IowaScaledEngineering/ckt-iiab/pg/ckt-iiab-test-v1.0-c82176f/ckt-iiab-test-drc.txt

** Drc report for /home/ndholmes/data/projects/ckt-iiab/kicad/ckt-iiab-test/ckt-iiab-test.kicad_pcb **
** Created on 2024-12-31 19:53:41 **

** Found 0 DRC violations **

** Found 0 unconnected pads **

** Found 0 Footprint errors **

** End of Report **
