IowaScaledEngineering/ckt-iiab/pg/ckt-iiab-test-v1.0-c82176f/ckt-iiab-test.pdf

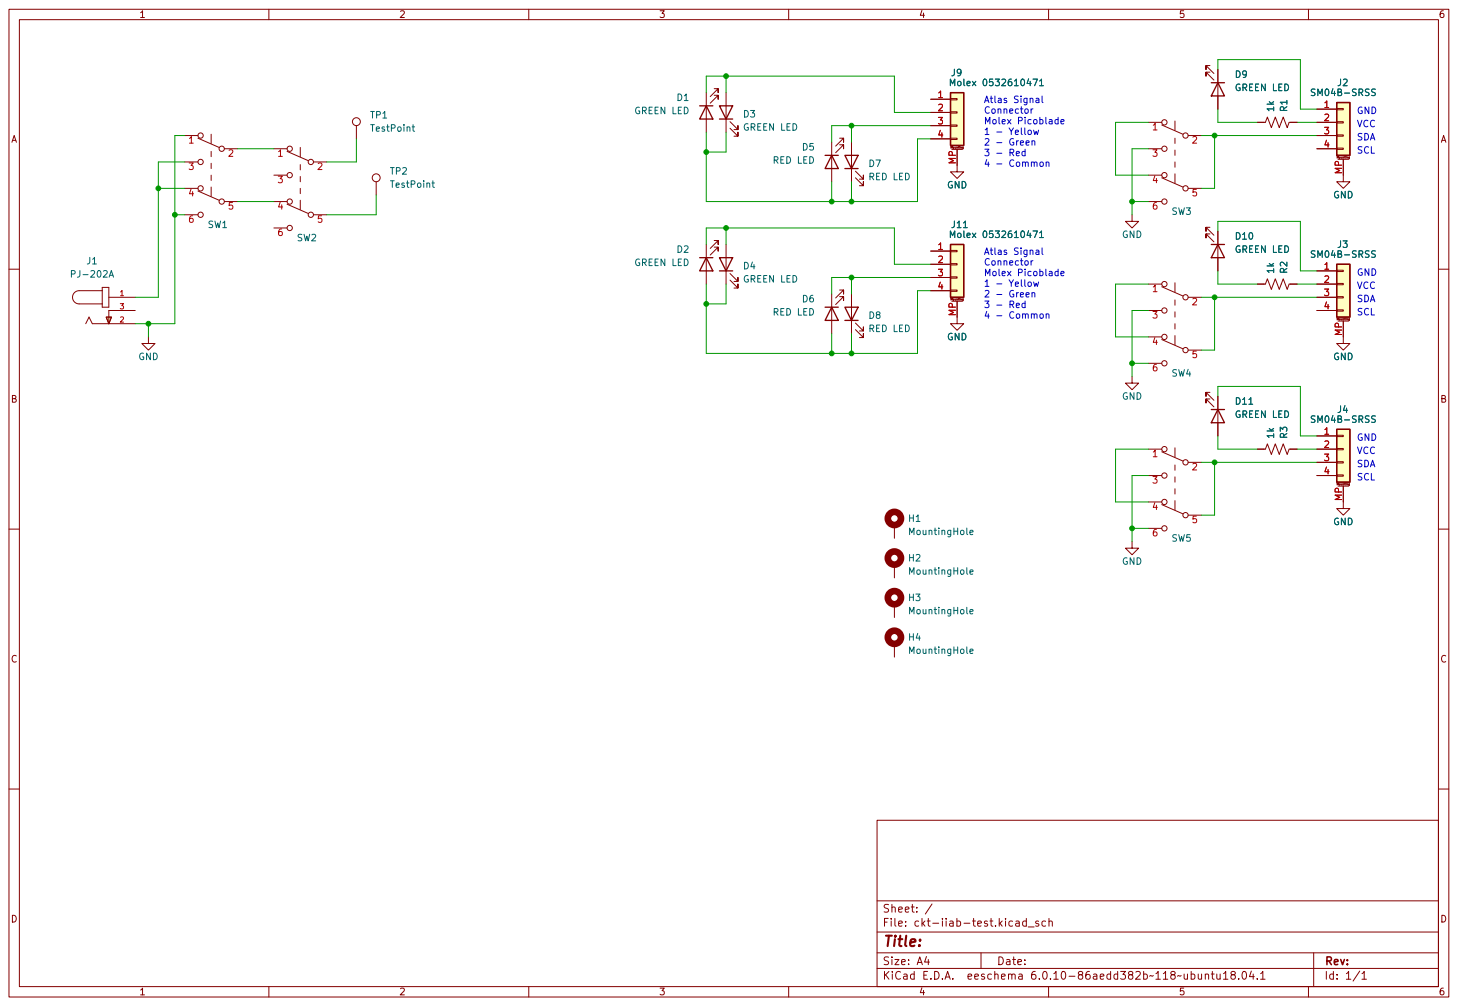
[picture p1: page 1]

J9Molex 0532610471 1234 MP
J2 SM04B-SRSS 1234 MP GND 1kR1 GND
J4 SM04B-SRSS 1234 MP GND 1kR2

Atlas Signal Connector Molex Picoblade

File: ckt-iiab-test.kicad_sch Sheet: /
