IowaScaledEngineering/ckt-iiab/pg/ckt-iiab-v1.3-1032111/ckt-iiab.pdf

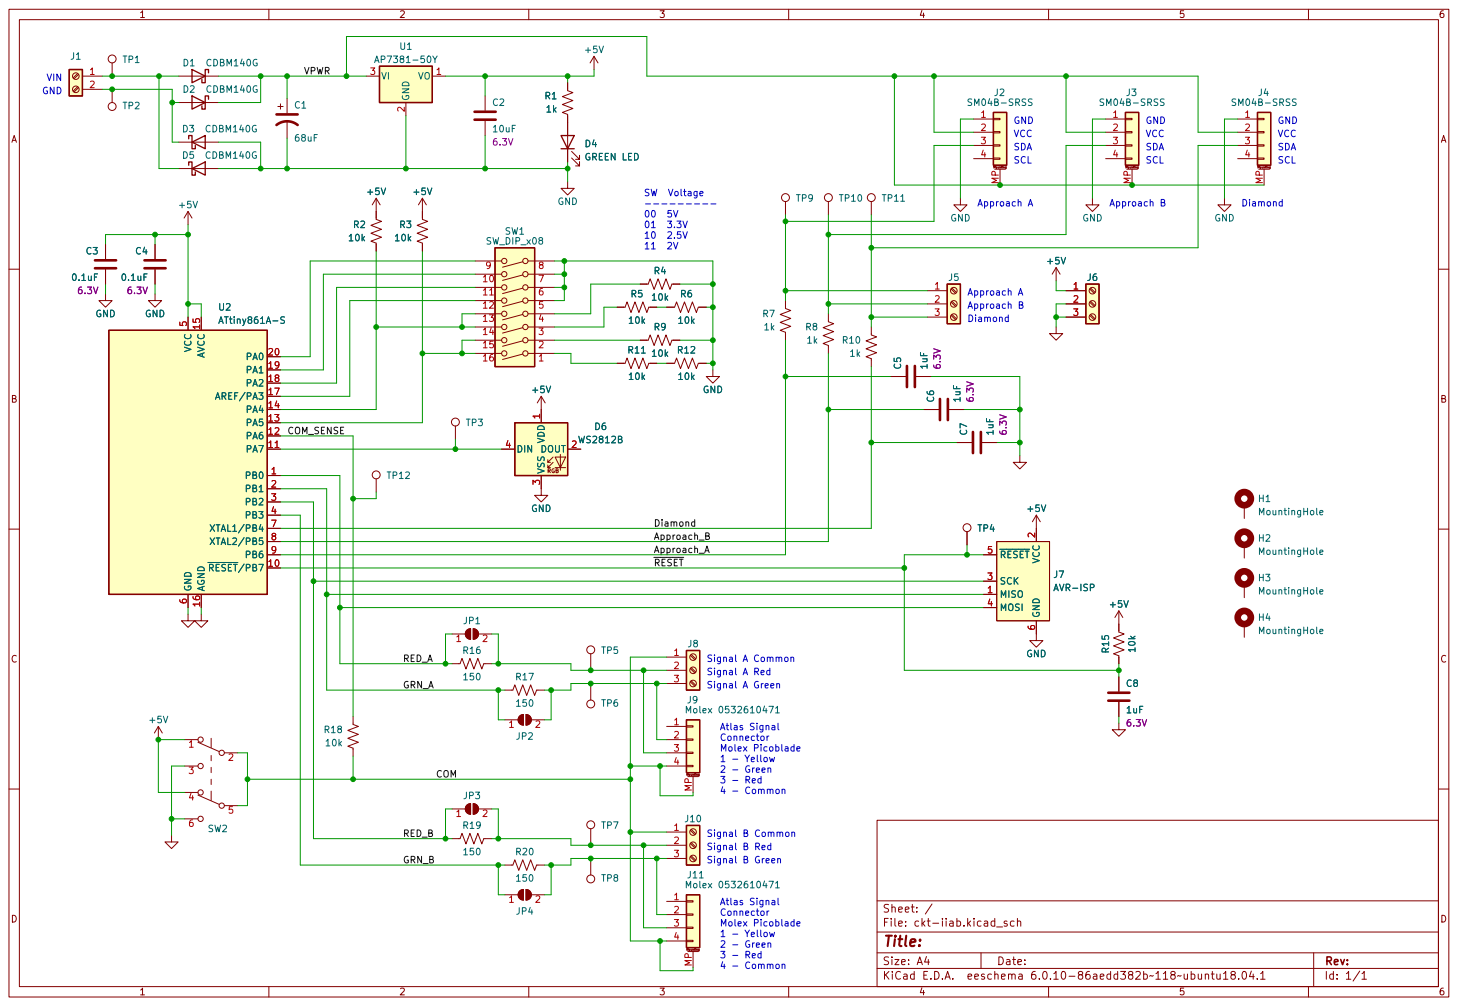
[picture p2: page 1]

2 SCK 3 MOSI 4 ~{RESET} 5 GND

Atlas Signal Connector Molex Picoblade

File: ckt-iiab.kicad_sch Sheet: /
Id: 1/1 Title:
