IowaScaledEngineering/ckt-iiab/pg/ckt-iiab-v1.1-c625275/ckt-iiab.pdf

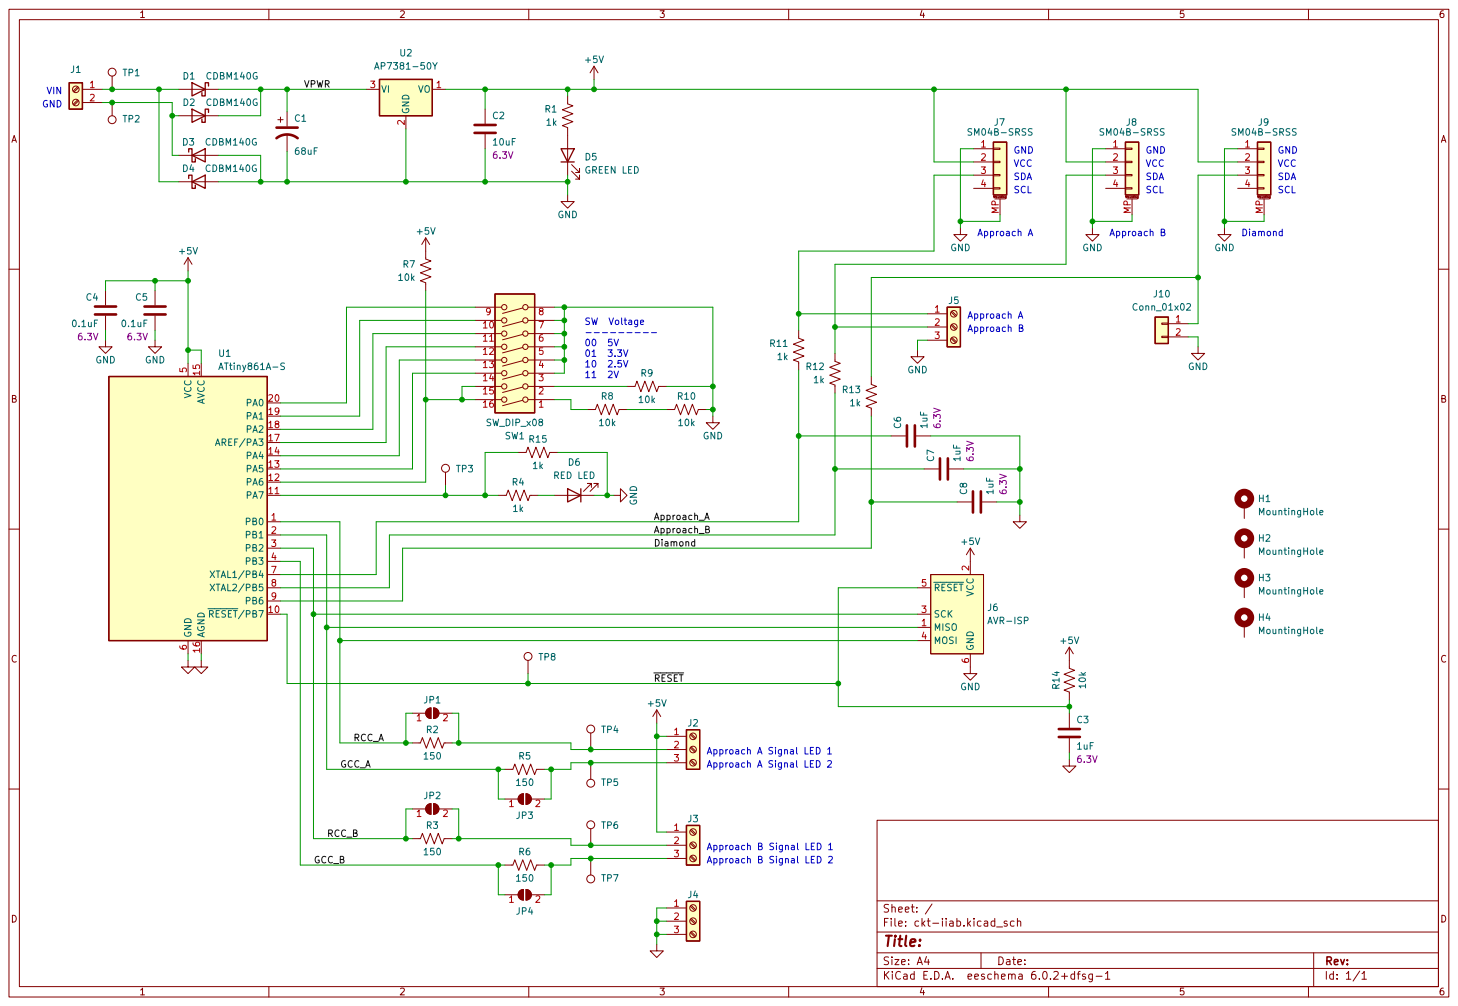
[picture p3: page 1]

10 | 7
11 | 6
12 | 5
13 | 4

2 SCK 3 MOSI 4 ~{RESET} 5 GND

File: ckt-iiab.kicad_sch Sheet: /
Id: 1/1 Title:
