IowaScaledEngineering/ckt-iiab/src/iiab-delay-test/iiab-delay-test.ino

/*************************************************************************
Title:    IIAB Delay Test Fixture
Authors:  Michael Petersen <railfan@drgw.net>
File:     $Id: $
License:  GNU General Public License v3

LICENSE:
    Copyright (C) 2024 Nathan D. Holmes & Michael D. Petersen

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
*************************************************************************/

// Command to log data:
// (stty raw; cat > delay04.log) < /dev/ttyUSB1

void setup() {
	digitalWrite(2, HIGH);
	digitalWrite(3, HIGH);
	digitalWrite(4, HIGH);
	pinMode(2, OUTPUT);  // Approach A
	pinMode(3, OUTPUT);  // Diamond
	pinMode(4, OUTPUT);  // Approach B
	pinMode(5, INPUT);   // Signal A Green (Common Anode)
	Serial.begin(115200);
	while(!Serial);
}

unsigned long timeA, timeB;

uint32_t i = 0;

void loop() {
	digitalWrite(2, LOW);  // Trigger approach
	timeA = millis();
	while(HIGH == digitalRead(5));  // Wait for green
	timeB = millis();
	Serial.print(i);
	Serial.print(',');
	Serial.print(timeB-timeA);
	Serial.print('\n');
	delay(250);
	digitalWrite(3, LOW);  // Clear out interlocking
	delay(250);
	digitalWrite(4, LOW);
	delay(250);
	digitalWrite(2, HIGH);
	delay(250);
	digitalWrite(3, HIGH);
	delay(250);
	digitalWrite(4, HIGH);
	delay(500);
	i++;
}
