IowaScaledEngineering/ckt-iiab/(commit log)

2024-03-12 Updated schematic
    [ckt-iiab.kicad_sch]
2024-03-14 Updated schematic with latest definition
    [ckt-iiab.kicad_sch]
2024-03-20 Layout complete
    [ckt-iiab.kicad_pcb, ckt-iiab.kicad_sch]
2024-04-02 Moved board text
    [ckt-iiab.kicad_pcb]
2024-04-04 Spread out connectors and updated text
    [ckt-iiab.kicad_pcb, ckt-iiab.kicad_sch]
2024-04-06 Fixed DRC
    [ckt-iiab.kicad_pcb]
2024-04-06 Files for fab
    [ckt-iiab-NPTH.drl, ckt-iiab.drl, ckt-iiab.gbl, ckt-iiab.gbo, ckt-iiab.gbp, ckt-iiab.gbr, ckt-iiab.gbs, ckt-iiab.gm1]
2024-04-28 Fixed DIP sw footprint
    [ckt-iiab.kicad_pcb, ckt-iiab.kicad_sch]
2024-05-21 Changed diode to SOD-123T footprint
    [ckt-iiab.kicad_pcb, ckt-iiab.kicad_sch]
2024-05-21 Moved IO lines to get caps off programming lines.
    [ckt-iiab.kicad_pcb, ckt-iiab.kicad_sch]
2024-07-01 Fixed switch text
    [ckt-iiab.kicad_pcb]
2024-07-09 Sent to fab July 2024
    [ckt-iiab-NPTH.drl, ckt-iiab.drl, ckt-iiab.gbl, ckt-iiab.gbo, ckt-iiab.gbp, ckt-iiab.gbr, ckt-iiab.gbs, ckt-iiab.gm1]
2024-08-24 Updated for v1.1 board
2024-08-25 Updates after review
    [ckt-iiab.kicad_pcb, ckt-iiab.kicad_sch]
2024-08-25 Added 3D model for switch.
    [ckt-iiab.kicad_pcb]
2024-08-26 pg 1.2
    [ckt-iiab-NPTH.drl, ckt-iiab.drl, ckt-iiab.gbl, ckt-iiab.gbo, ckt-iiab.gbp, ckt-iiab.gbr, ckt-iiab.gbs, ckt-iiab.gm1]
2024-09-10 Added fixed delay settings
    [ckt-iiab.c, io.c, io.h]
2024-10-26 Test program and data
    [iiab-delay.ods]
2024-10-27 Debounce DIP switches, add test mode for DIP switches
2024-11-05 Start of v1.3. Added 5V terminal block for aux lighting.
    [ckt-iiab.kicad_pcb, ckt-iiab.kicad_sch]
2024-12-17 Fixed searchlight/randomized decode. Swapped middle timeout settings.
    [io.c]
2024-12-31 Test for IIAB
    [ckt-iiab-test.kicad_pcb, ckt-iiab-test.kicad_sch]
2025-01-01 Added metal
    [ckt-iiab-test.kicad_pcb, ckt-iiab-test.kicad_sch]
2025-01-12 Updated test results
    [iiab-delay.ods]
2025-01-13 Production firmware
    [iiab-delay.ods]
