IowaScaledEngineering/ckt-iiab/(notices)

Notices in the files:
kicad/ckt-iiab/ckt-iiab.kicad_pcb:
©2024 CC BY-SA
kicad/ckt-iiab-test/ckt-iiab-test.kicad_pcb:
©2025 CC BY-SA
